KanurkarPrateek/pip-bot/images/back.png

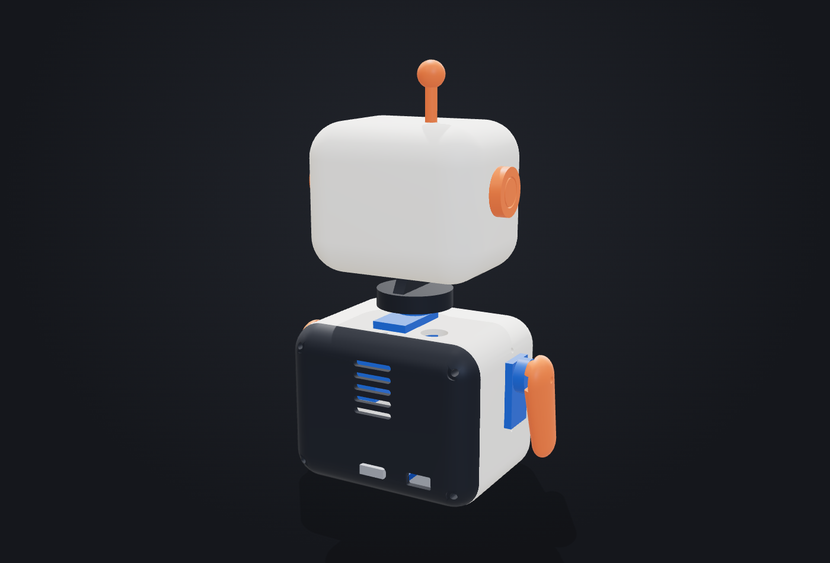
images/back.png
