KanurkarPrateek/pip-bot/images/expr/angry.png

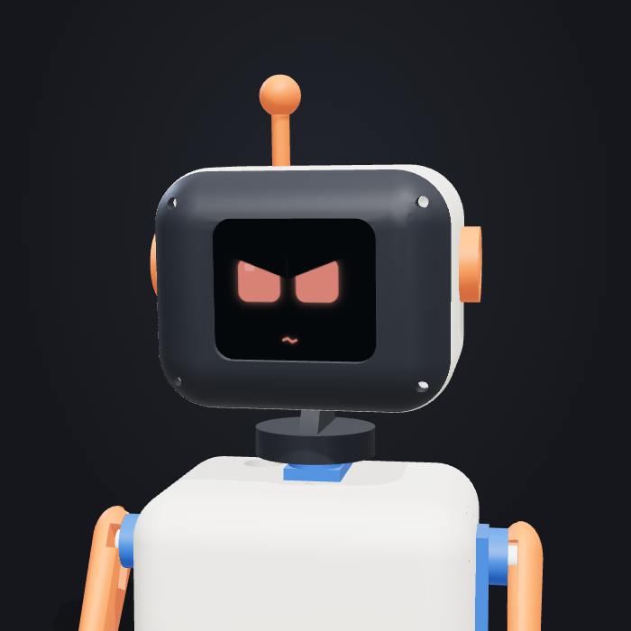
images/expr/angry.png
