KanurkarPrateek/pip-bot/stl/neck.stl

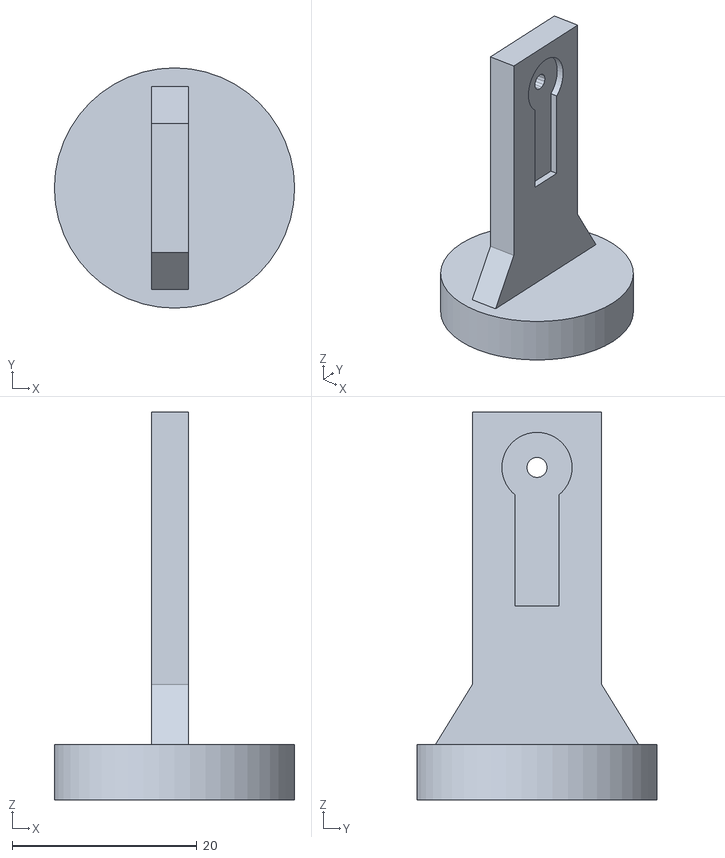
[picture p7: CAD file, 2026-10-27]
stl/neck.stl
26.0 x 26.0 x 42.0
