KanurkarPrateek/pip-bot/stl/ear_x2.stl

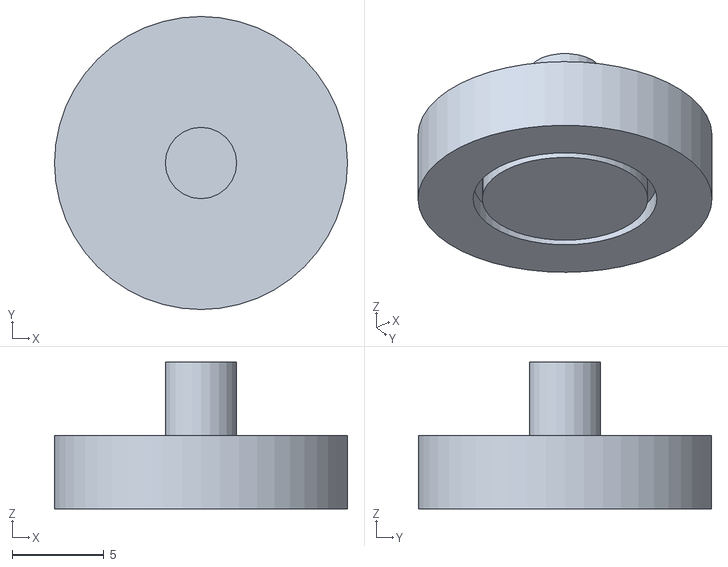
[picture p8: CAD file, 2026-10-27]
stl/ear_x2.stl
16.0 x 16.0 x 8.00
