KanurkarPrateek/pip-bot/stl/back_cover.stl

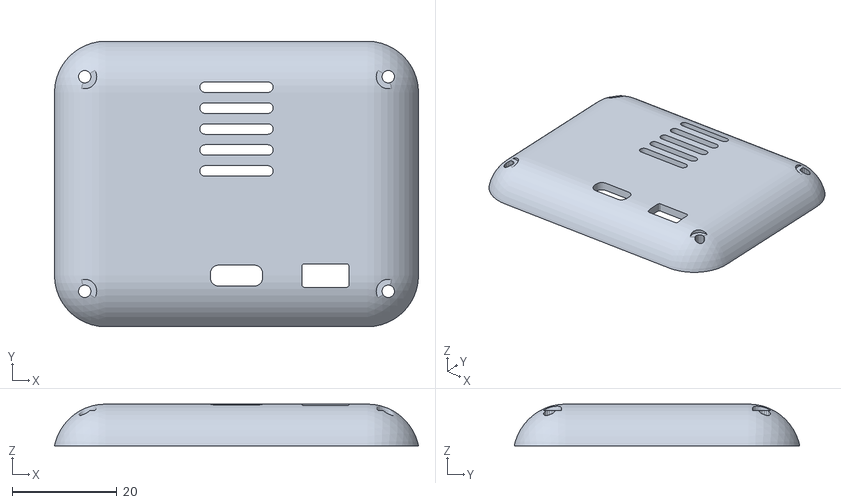
[picture p9: CAD file, 2026-10-27]
stl/back_cover.stl
69.6 x 54.6 x 8.00
