KanurkarPrateek/pip-bot/stl/head_shell.stl

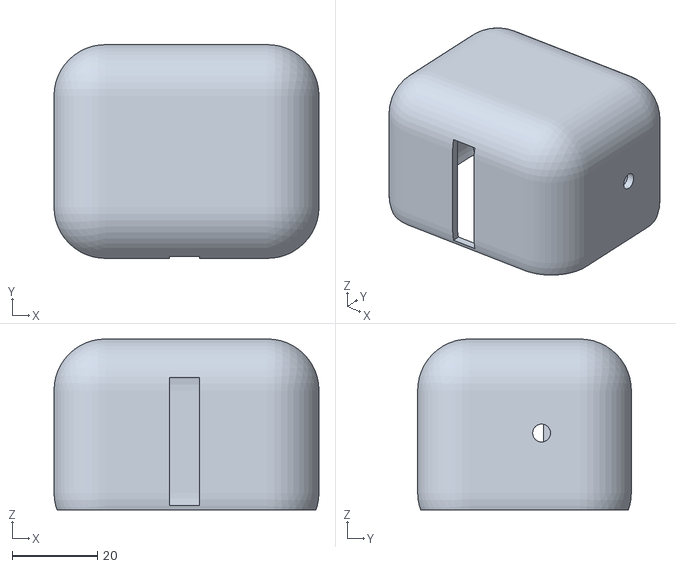
[picture p10: CAD file, 2026-10-27]
stl/head_shell.stl
62.0 x 50.0 x 40.0
