KanurkarPrateek/pip-bot/stl/face_bezel.stl

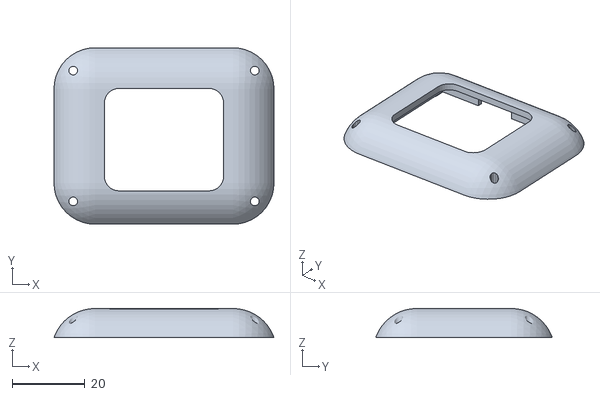
[picture p11: CAD file, 2026-10-27]
stl/face_bezel.stl
60.6 x 48.6 x 8.00
