KanurkarPrateek/pip-bot/stl/body_shell.stl

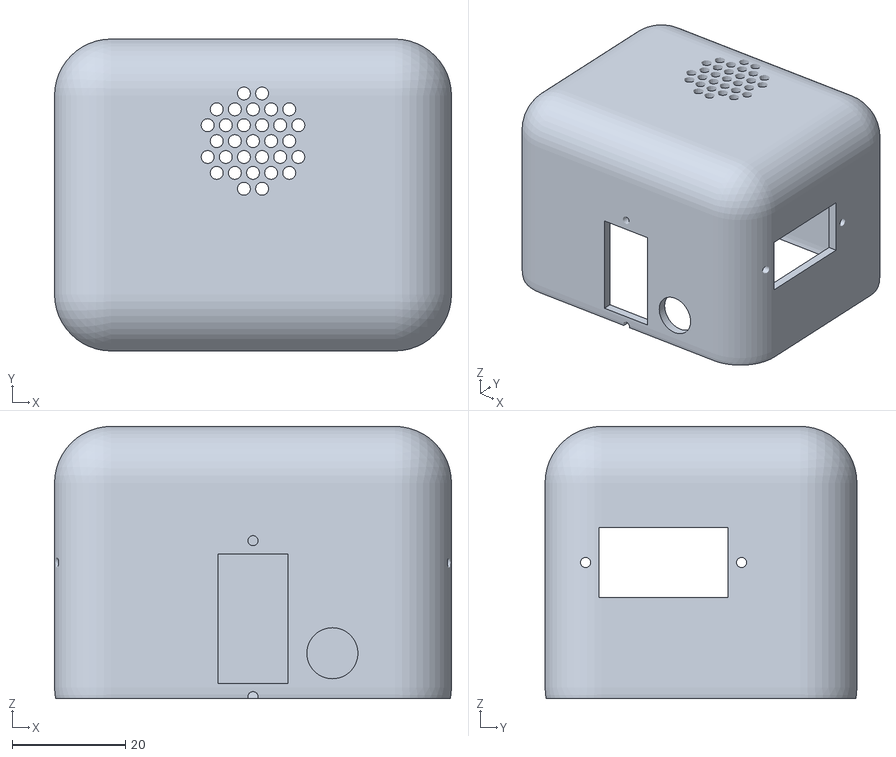
[picture p12: CAD file, 2026-10-27]
stl/body_shell.stl
70.0 x 55.0 x 48.0
