KanurkarPrateek/pip-bot/stl/arm_x2.stl

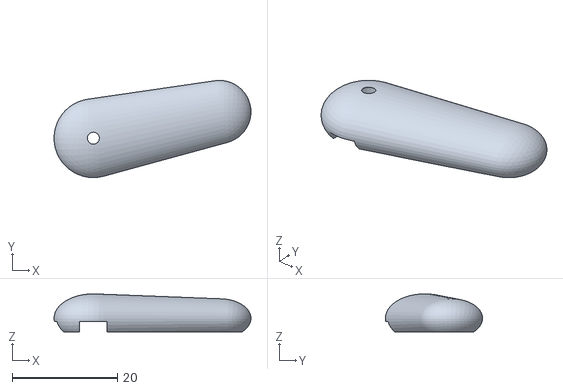
[picture p13: CAD file, 2026-10-27]
stl/arm_x2.stl
37.5 x 18.5 x 7.21
