KanurkarPrateek/pip-bot/stl/antenna.stl

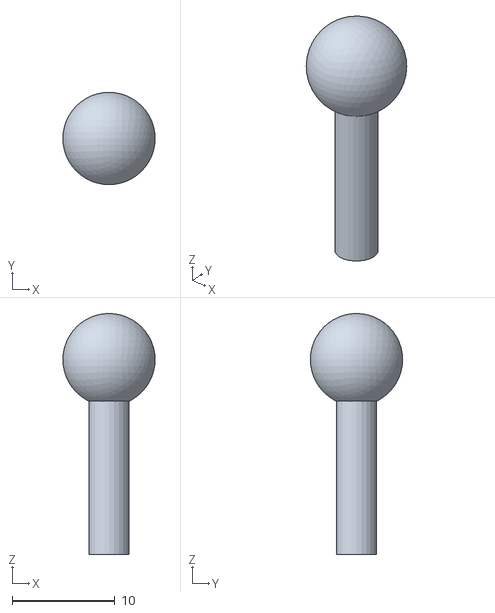
[picture p14: CAD file, 2026-10-27]
stl/antenna.stl
9.00 x 9.00 x 23.5
